nippoo/lawrencebutton/Electronics/lawrencebutton.kicad_pcb

## KiCad design Electronics/lawrencebutton.kicad_pcb (2021-02-03)

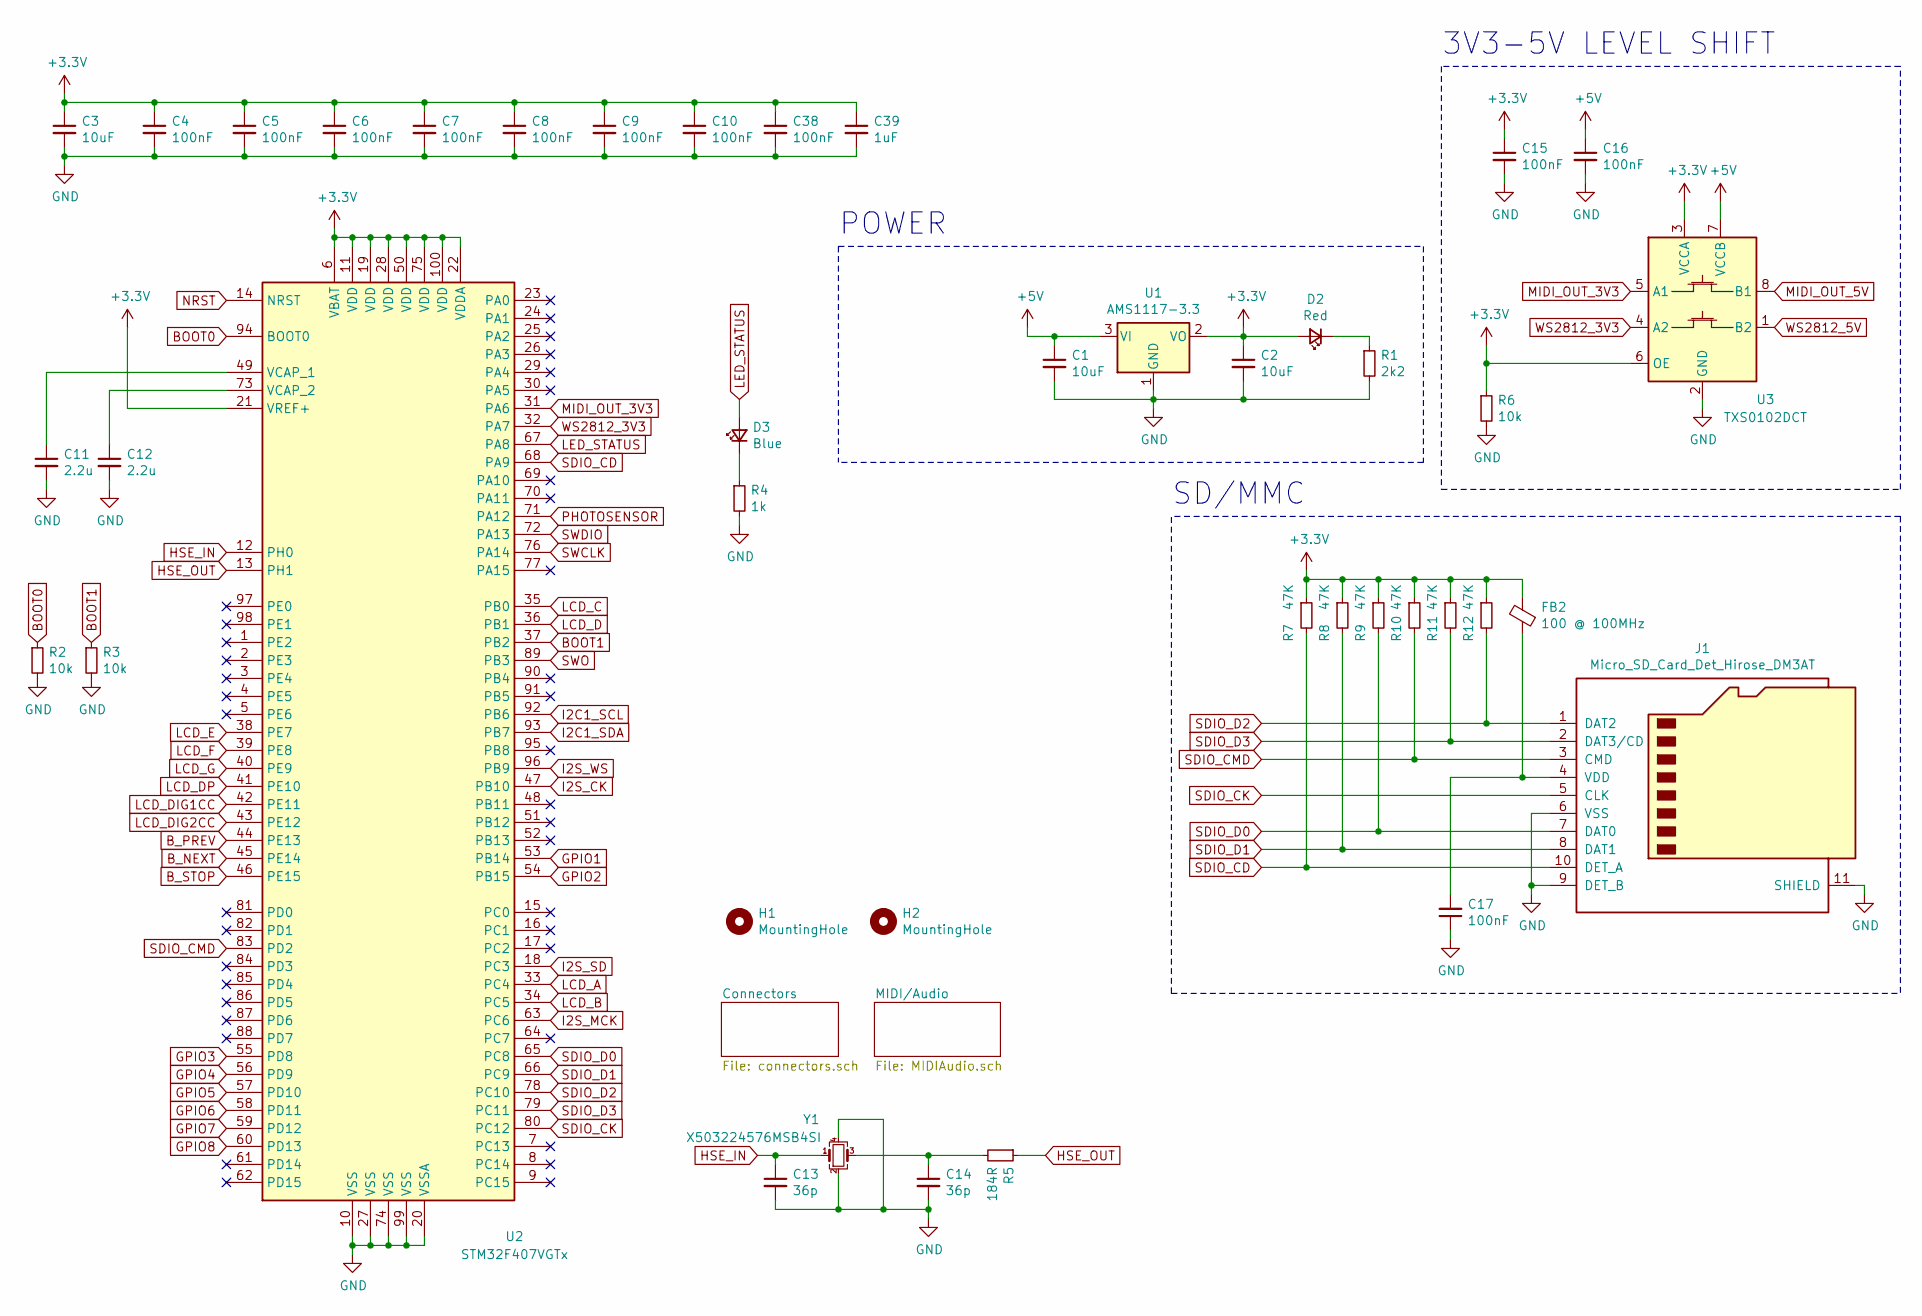
[picture p9: schematic lawrencebutton.sch, Lawrence Button Main Board]

Parts:
C1: 10uF; C_0603_1608Metric; LCSC C19702
C2, C3: 10uF; C_0402_1005Metric; LCSC C15525
C4, C5, C6, C7, C8, C9, C10, C15, C16, C17, C38: 100nF; C_0402_1005Metric; LCSC C1525
C11, C12: 2.2u; C_0603_1608Metric; LCSC C23630
C13, C14: 36p; C_0603_1608Metric; LCSC C1663
C39: 1uF; C_0402_1005Metric; LCSC C52923
D2: Red; LED_0805_2012Metric; LCSC C84256
D3: Blue; LED_0805_2012Metric; LCSC C2293
FB2: 100 @ 100MHz; L_0805_2012Metric; LCSC C1015
H1, H2: MountingHole; MountingHole_3.2mm_M3_Pad_Via
J1: Micro_SD_Card_Det_Hirose_DM3AT; microSD_HC_Hirose_DM3AT-SF-PEJM5
R1: 2k2; R_0603_1608Metric; LCSC C4190
R2, R3, R6: 10k; R_0603_1608Metric; LCSC C25804
R4: 1k; R_0603_1608Metric; LCSC C21190
R5: 184R; R_0603_1608Metric; LCSC C22828
R7, R8, R9, R10, R11, R12: 47K; R_0402_1005Metric; LCSC C25792
U1: AMS1117-3.3; SOT-223-3_TabPin2; LCSC C6186
U2: STM32F407VGTx; LQFP-100_14x14mm_P0.5mm; LCSC C12345
U3: TXS0102DCT; SSOP-8_2.95x2.8mm_P0.65mm; LCSC C324082
Y1: X503224576MSB4SI; Crystal_SMD_5032-4Pin_5.0x3.2mm; LCSC C112578

Connections:
+3V3: C2.1, C3.1, C4.1, C5.1, C6.1, C7.1, C8.1, C9.1, C10.1, C15.1, C38.1, C39.1, D2.2 (A), FB2.2, R6.1, R7.1, R8.1, R9.1, R10.1, R11.1, R12.1, U1.2 (VO), U2.6 (VBAT), U2.11 (VDD), U2.19 (VDD), U2.21 (VREF+), U2.22 (VDDA), U2.28 (VDD), U2.50 (VDD), U2.75 (VDD), U2.100 (VDD), U3.3 (VCCA), U3.6 (OE); also elsewhere on the board
+5V: C1.1, C16.1, U1.3 (VI), U3.7 (VCCB); also elsewhere on the board
BOOT0: R2.1, U2.94 (BOOT0)
BOOT1: R3.1, U2.37 (PB2)
B_NEXT: U2.45 (PE14); also elsewhere on the board
B_PREV: U2.44 (PE13); also elsewhere on the board
B_STOP: U2.46 (PE15); also elsewhere on the board
GND: C1.2, C2.2, C3.2, C4.2, C5.2, C6.2, C7.2, C8.2, C9.2, C10.2, C11.2, C12.2, C13.2, C14.2, C15.2, C16.2, C17.1, C38.2, C39.2, J1.6 (VSS), J1.9 (DET_B), J1.11 (SHIELD), R1.2, R2.2, R3.2, R4.2, R6.2, U1.1 (GND), U2.10 (VSS), U2.20 (VSSA), U2.27 (VSS), U2.74 (VSS), U2.99 (VSS), U3.2 (GND), Y1.2, Y1.4; also elsewhere on the board
GPIO1: U2.53 (PB14); also elsewhere on the board
GPIO2: U2.54 (PB15); also elsewhere on the board
GPIO3: U2.55 (PD8); also elsewhere on the board
GPIO4: U2.56 (PD9); also elsewhere on the board
GPIO5: U2.57 (PD10); also elsewhere on the board
GPIO6: U2.58 (PD11); also elsewhere on the board
GPIO7: U2.59 (PD12); also elsewhere on the board
GPIO8: U2.60 (PD13); also elsewhere on the board
HSE_IN: C13.1, U2.12 (PH0), Y1.1
HSE_OUT: R5.1, U2.13 (PH1)
I2C1_SCL: U2.92 (PB6); also elsewhere on the board
I2C1_SDA: U2.93 (PB7); also elsewhere on the board
I2S_CK: U2.47 (PB10); also elsewhere on the board
I2S_MCK: U2.63 (PC6); also elsewhere on the board
I2S_SD: U2.18 (PC3); also elsewhere on the board
I2S_WS: U2.96 (PB9); also elsewhere on the board
LCD_A: U2.33 (PC4); also elsewhere on the board
LCD_B: U2.34 (PC5); also elsewhere on the board
LCD_C: U2.35 (PB0); also elsewhere on the board
LCD_D: U2.36 (PB1); also elsewhere on the board
LCD_DIG1CC: U2.42 (PE11); also elsewhere on the board
LCD_DIG2CC: U2.43 (PE12); also elsewhere on the board
LCD_DP: U2.41 (PE10); also elsewhere on the board
LCD_E: U2.38 (PE7); also elsewhere on the board
LCD_F: U2.39 (PE8); also elsewhere on the board
LCD_G: U2.40 (PE9); also elsewhere on the board
LED_STATUS: D3.2 (A), U2.67 (PA8)
MIDI_OUT_3V3: U2.31 (PA6), U3.5 (A1)
MIDI_OUT_5V: U3.8 (B1); also elsewhere on the board
NRST: U2.14 (NRST); also elsewhere on the board
unnamed: C11.1, U2.49 (VCAP_1)
unnamed: C12.1, U2.73 (VCAP_2)
unnamed: C14.1, R5.2, Y1.3
unnamed: C17.2, FB2.1, J1.4 (VDD)
unnamed: D2.1 (K), R1.1
unnamed: D3.1 (K), R4.1
PHOTOSENSOR: U2.71 (PA12); also elsewhere on the board
SDIO_CD: J1.10 (DET_A), R7.2, U2.68 (PA9)
SDIO_CK: J1.5 (CLK), U2.80 (PC12)
SDIO_CMD: J1.3 (CMD), R10.2, U2.83 (PD2)
SDIO_D0: J1.7 (DAT0), R9.2, U2.65 (PC8)
SDIO_D1: J1.8 (DAT1), R8.2, U2.66 (PC9)
SDIO_D2: J1.1 (DAT2), R12.2, U2.78 (PC10)
SDIO_D3: J1.2 (DAT3/CD), R11.2, U2.79 (PC11)
SWCLK: U2.76 (PA14); also elsewhere on the board
SWDIO: U2.72 (PA13); also elsewhere on the board
SWO: U2.89 (PB3); also elsewhere on the board
WS2812_3V3: U2.32 (PA7), U3.4 (A2)
WS2812_5V: U3.1 (B2); also elsewhere on the board

Notes on the sheet:
SD/MMC
POWER
3V3-5V LEVEL SHIFT

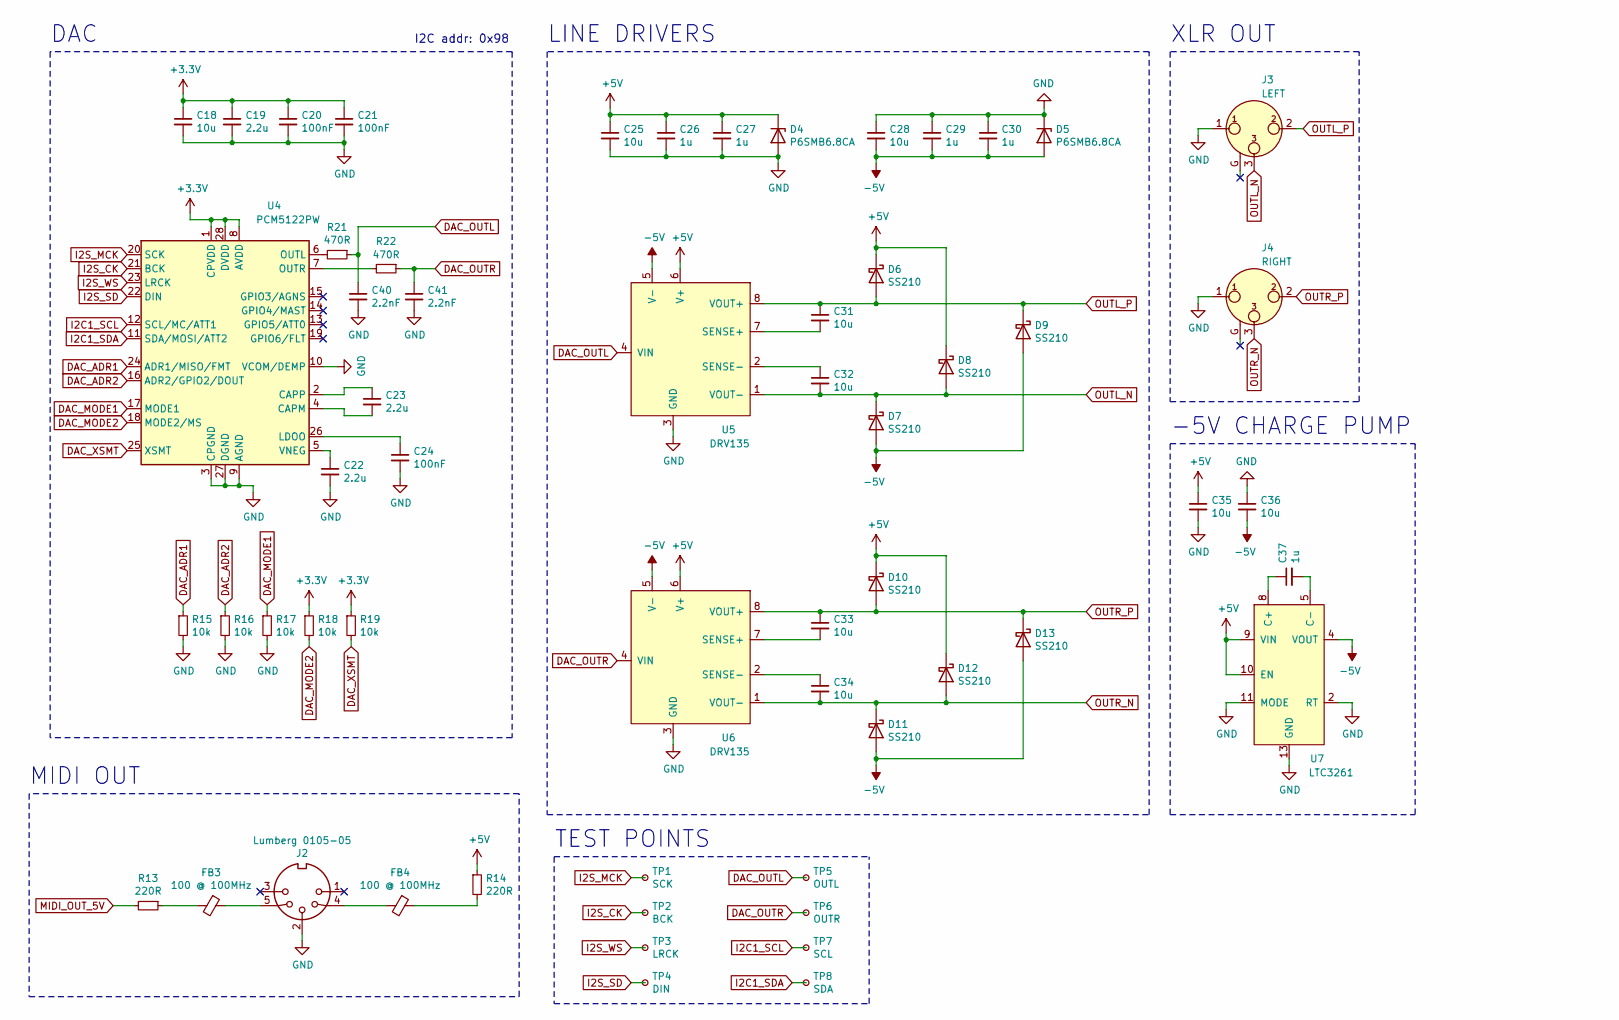
[picture p10: schematic MIDIAudio.sch, Lawrence Button Main Board, part in row 1, column 1]

Parts:
C18: 10u; C_0402_1005Metric; LCSC C15525
C19, C22, C23: 2.2u; C_0603_1608Metric; LCSC C23630
C20, C21, C24: 100nF; C_0402_1005Metric; LCSC C1525
C25, C28, C31, C32, C33, C34, C35, C36: 10u; C_0603_1608Metric; LCSC C19702
C26, C27, C29, C30, C37: 1u; C_0402_1005Metric; LCSC C52923
C40, C41: 2.2nF; C_0402_1005Metric; LCSC C1531
D4, D5: P6SMB6.8CA; D_SMB; LCSC C78395
D6, D7, D8, D9, D10, D11, D12, D13: SS210; D_SMA; LCSC C14996
FB3, FB4: 100 @ 100MHz; L_0805_2012Metric; LCSC C1015
J2: Lumberg 0105-05; Lumberg-0105-05
J3: LEFT; Jack_XLR_Neutrik_NC3MAH_Horizontal
J4: RIGHT; Jack_XLR_Neutrik_NC3MAH_Horizontal
R13, R14: 220R; R_0603_1608Metric; LCSC C22962
R15, R16, R17, R18, R19: 10k; R_0603_1608Metric; LCSC C25804
R21, R22: 470R; R_0402_1005Metric; LCSC C25117
TP1: SCK; TestPoint_Loop_D2.50mm_Drill1.0mm
TP2: BCK; TestPoint_Loop_D2.50mm_Drill1.0mm
TP3: LRCK; TestPoint_Loop_D2.50mm_Drill1.0mm
TP4: DIN; TestPoint_Loop_D2.50mm_Drill1.0mm
TP5: OUTL; TestPoint_Loop_D2.50mm_Drill1.0mm
TP6: OUTR; TestPoint_Loop_D2.50mm_Drill1.0mm
TP7: SCL; TestPoint_Loop_D2.50mm_Drill1.0mm
TP8: SDA; TestPoint_Loop_D2.50mm_Drill1.0mm
U4: PCM5122PW; TSSOP-28_4.4x9.7mm_P0.65mm
U5, U6: DRV135; SOIC-8_3.9x4.9mm_P1.27mm
U7: LTC3261; MSOP-12-1EP_3x4mm_P0.65mm_EP1.65x2.85mm_ThermalVias

Connections:
+3V3: C18.1, C19.1, C20.1, C21.1, R18.1, R19.1, U4.1 (CPVDD), U4.8 (AVDD), U4.28 (DVDD); also elsewhere on the board
+5V: C25.1, C26.1, C27.1, C35.1, D4.1 (K), D6.1 (K), D8.1 (K), D10.1 (K), D12.1 (K), R14.1, U5.6 (V+), U6.6 (V+), U7.9 (VIN), U7.10 (EN); also elsewhere on the board
-5V: C28.2, C29.2, C30.2, C36.2, D5.2 (A), D7.2 (A), D9.2 (A), D11.2 (A), D13.2 (A), U5.5 (V-), U6.5 (V-), U7.4 (VOUT)
DAC_ADR1: R15.1, U4.24 (ADR1/MISO/FMT)
DAC_ADR2: R16.1, U4.16 (ADR2/GPIO2/DOUT)
DAC_MODE1: R17.1, U4.17 (MODE1)
DAC_MODE2: R18.2, U4.18 (MODE2/MS)
DAC_OUTL: C40.1, R21.1, TP5.1, U5.4 (VIN)
DAC_OUTR: C41.1, R22.1, TP6.1, U6.4 (VIN)
DAC_XSMT: R19.2, U4.25 (XSMT)
GND: C18.2, C19.2, C20.2, C21.2, C22.2, C24.2, C25.2, C26.2, C27.2, C28.1, C29.1, C30.1, C35.2, C36.1, C40.2, C41.2, D4.2 (A), D5.1 (K), J2.2, J3.1, J4.1, R15.2, R16.2, R17.2, U4.3 (CPGND), U4.9 (AGND), U4.10 (VCOM/DEMP), U4.27 (DGND), U5.3 (GND), U6.3 (GND), U7.2 (RT), U7.11 (MODE), U7.13 (GND); also elsewhere on the board
I2C1_SCL: TP7.1, U4.12 (SCL/MC/ATT1); also elsewhere on the board
I2C1_SDA: TP8.1, U4.11 (SDA/MOSI/ATT2); also elsewhere on the board
I2S_CK: TP2.1, U4.21 (BCK); also elsewhere on the board
I2S_MCK: TP1.1, U4.20 (SCK); also elsewhere on the board
I2S_SD: TP4.1, U4.22 (DIN); also elsewhere on the board
I2S_WS: TP3.1, U4.23 (LRCK); also elsewhere on the board
MIDI_OUT_5V: R13.2; also elsewhere on the board
unnamed: C22.1, U4.5 (VNEG)
unnamed: C23.1, U4.2 (CAPP)
unnamed: C23.2, U4.4 (CAPM)
unnamed: C24.1, U4.26 (LDOO)
unnamed: C31.2, U5.7 (SENSE+)
unnamed: C32.1, U5.2 (SENSE-)
unnamed: C33.2, U6.7 (SENSE+)
unnamed: C34.1, U6.2 (SENSE-)
unnamed: C37.1, U7.8 (C+)
unnamed: C37.2, U7.5 (C-)
unnamed: FB3.1, J2.5
unnamed: FB3.2, R13.1
unnamed: FB4.1, R14.2
unnamed: FB4.2, J2.4
unnamed: R21.2, U4.6 (OUTL)
unnamed: R22.2, U4.7 (OUTR)
OUTL_N: C32.2, D7.1 (K), D8.2 (A), J3.3, U5.1 (VOUT-)
OUTL_P: C31.1, D6.2 (A), D9.1 (K), J3.2, U5.8 (VOUT+)
OUTR_N: C34.2, D11.1 (K), D12.2 (A), J4.3, U6.1 (VOUT-)
OUTR_P: C33.1, D10.2 (A), D13.1 (K), J4.2, U6.8 (VOUT+)

Notes on the sheet:
XLR OUT
LINE DRIVERS
DAC
MIDI OUT
I2C addr: 0x98
-5V CHARGE PUMP
TEST POINTS

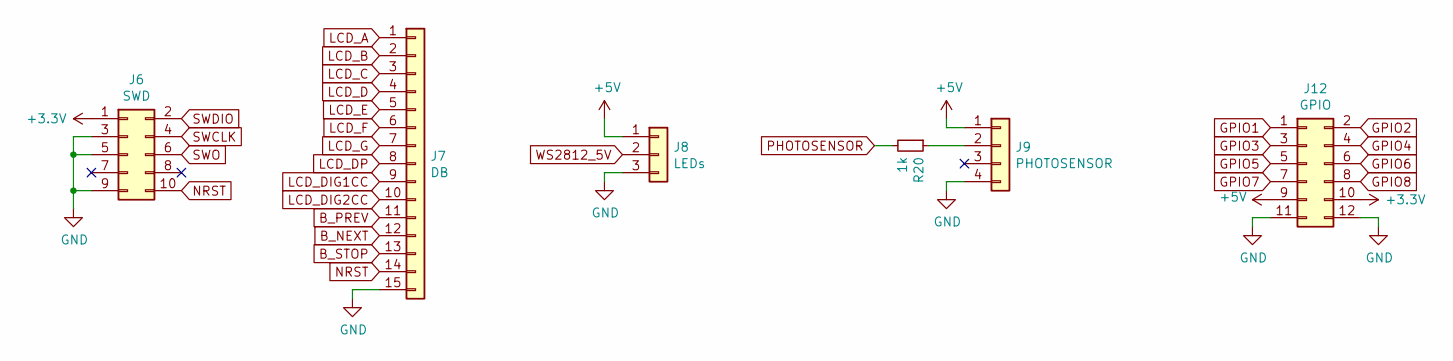
[picture p11: schematic connectors.sch, Lawrence Button Main Board]

Parts:
J6: SWD; PinHeader_2x05_P1.27mm_Vertical_SMD
J7: DB; Molex_PicoBlade_53048-1510_1x15_P1.25mm_Horizontal
J8: LEDs; Molex_PicoBlade_53048-0310_1x03_P1.25mm_Horizontal
J9: PHOTOSENSOR; Molex_PicoBlade_53048-0410_1x04_P1.25mm_Horizontal
J12: GPIO; PinHeader_2x06_P2.54mm_Vertical
R20: 1k; R_0603_1608Metric; LCSC C21190

Connections:
+3V3: J6.1, J12.10; also elsewhere on the board
+5V: J8.1, J9.1, J12.9; also elsewhere on the board
B_NEXT: J7.12; also elsewhere on the board
B_PREV: J7.11; also elsewhere on the board
B_STOP: J7.13; also elsewhere on the board
GND: J6.3, J6.5, J6.9, J7.15, J8.3, J9.4, J12.11, J12.12; also elsewhere on the board
GPIO1: J12.1; also elsewhere on the board
GPIO2: J12.2; also elsewhere on the board
GPIO3: J12.3; also elsewhere on the board
GPIO4: J12.4; also elsewhere on the board
GPIO5: J12.5; also elsewhere on the board
GPIO6: J12.6; also elsewhere on the board
GPIO7: J12.7; also elsewhere on the board
GPIO8: J12.8; also elsewhere on the board
LCD_A: J7.1; also elsewhere on the board
LCD_B: J7.2; also elsewhere on the board
LCD_C: J7.3; also elsewhere on the board
LCD_D: J7.4; also elsewhere on the board
LCD_DIG1CC: J7.9; also elsewhere on the board
LCD_DIG2CC: J7.10; also elsewhere on the board
LCD_DP: J7.8; also elsewhere on the board
LCD_E: J7.5; also elsewhere on the board
LCD_F: J7.6; also elsewhere on the board
LCD_G: J7.7; also elsewhere on the board
NRST: J6.10, J7.14; also elsewhere on the board
unnamed: J9.2, R20.1
PHOTOSENSOR: R20.2; also elsewhere on the board
SWCLK: J6.4; also elsewhere on the board
SWDIO: J6.2; also elsewhere on the board
SWO: J6.6; also elsewhere on the board
WS2812_5V: J8.2; also elsewhere on the board

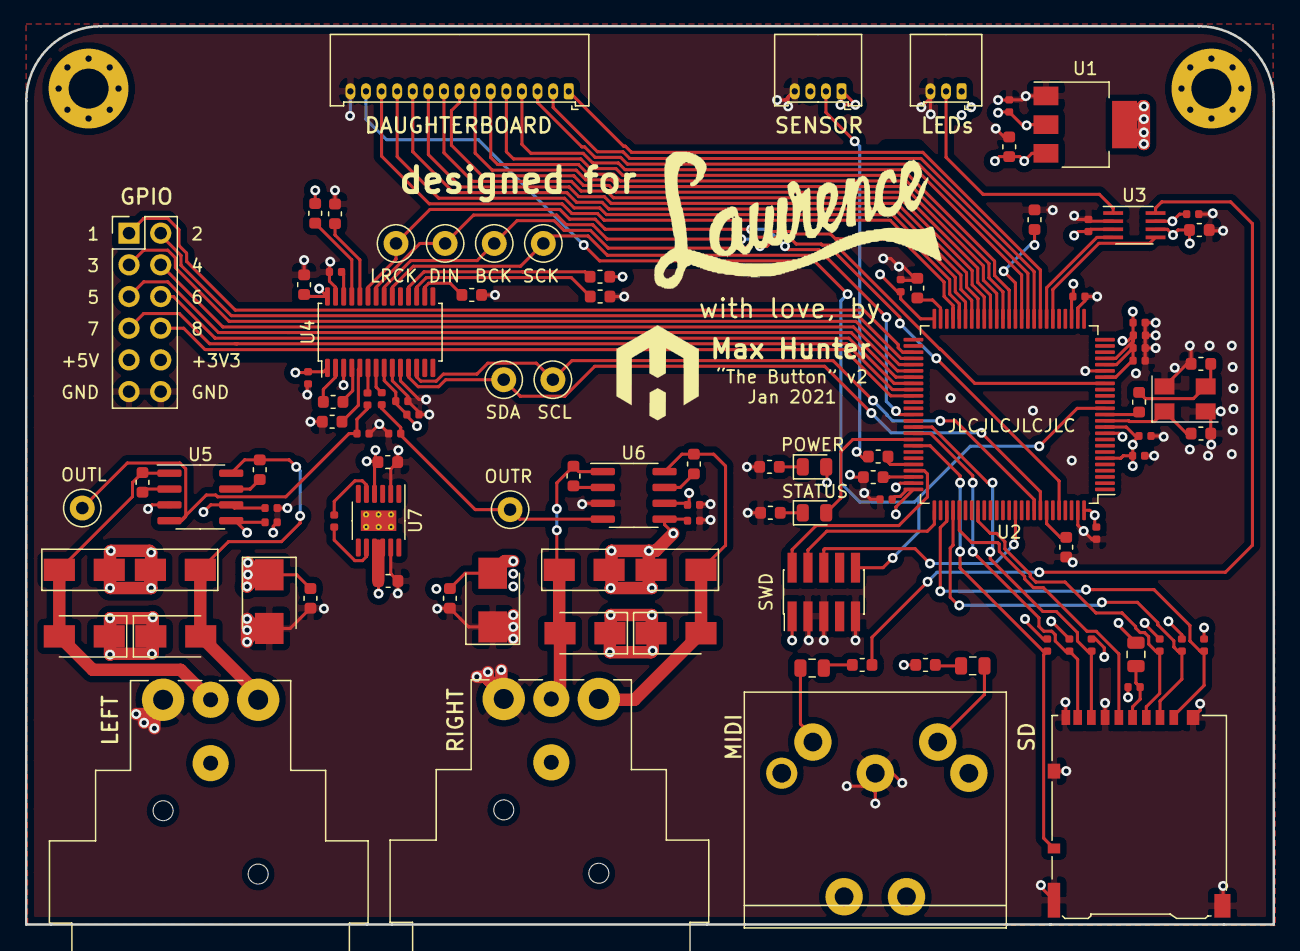
[picture p12: board lawrencebutton.kicad_pcb from above]

Board: 4 copper layers, 100.0 x 72.0 mm, 105 parts (0 on the bottom side), 86 nets.
