nippoo/lawrencebutton/Electronics/daughterboard.kicad_pcb

## KiCad design Electronics/daughterboard.kicad_pcb (2021-02-02)

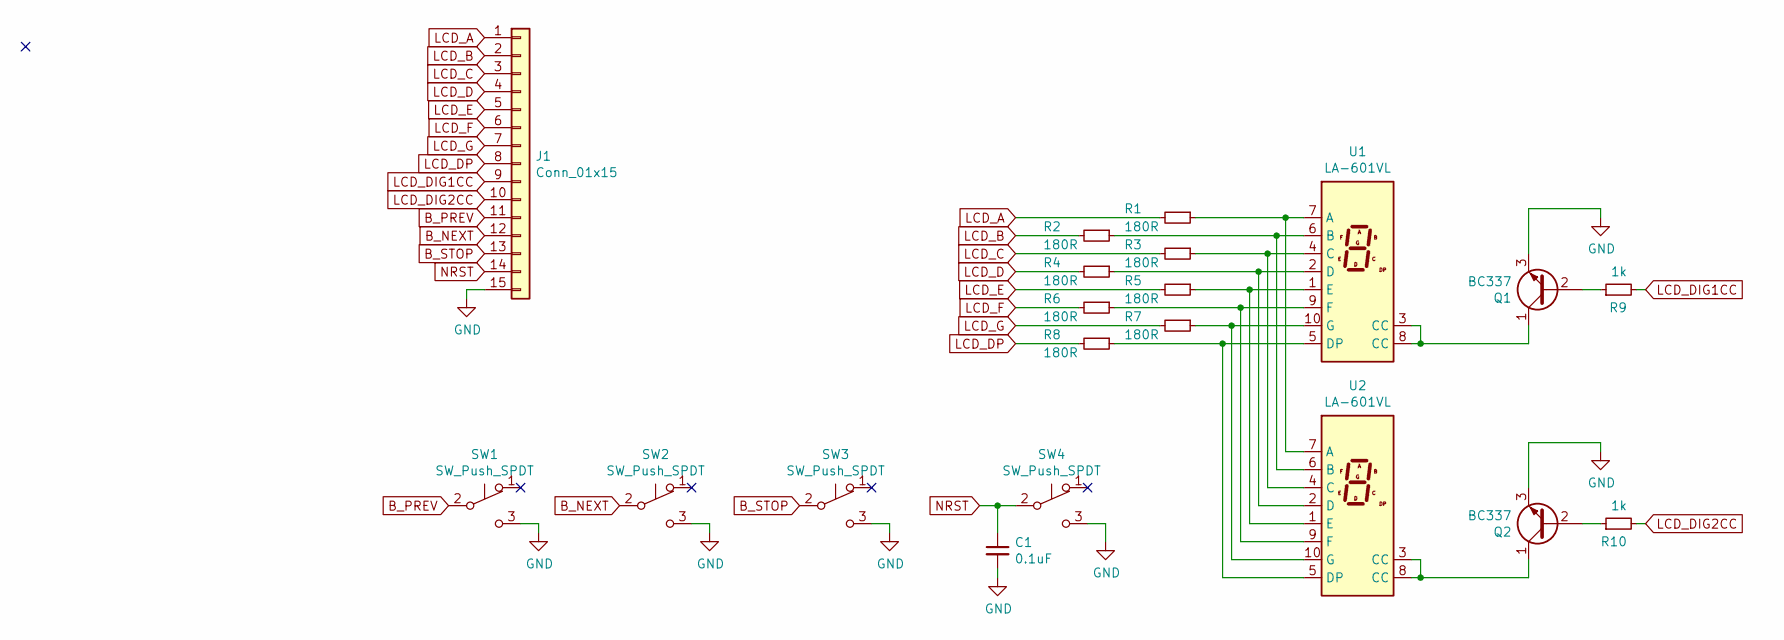
[picture p13: schematic daughterboard.sch]

Parts:
C1: 0.1uF; C_Disc_D3.8mm_W2.6mm_P2.50mm
J1: Conn_01x15; Molex_PicoBlade_53048-1510_1x15_P1.25mm_Horizontal
Q1, Q2: BC337; TO-92_Inline
R1, R2, R3, R4, R5, R6, R7, R8: 180R; R_Axial_DIN0207_L6.3mm_D2.5mm_P7.62mm_Horizontal
R9, R10: 1k; R_Axial_DIN0207_L6.3mm_D2.5mm_P7.62mm_Horizontal
SW1, SW2, SW3, SW4: SW_Push_SPDT; SPDT Push Switch RS 734-6788
U1, U2: LA-601VL; 7SegmentLED_LTS6760_LTS6780

Connections:
B_NEXT: J1.12, SW2.2 (B)
B_PREV: J1.11, SW1.2 (B)
B_STOP: J1.13, SW3.2 (B)
GND: C1.2, J1.15, Q1.3 (E), Q2.3 (E), SW1.3 (C), SW2.3 (C), SW3.3 (C), SW4.3 (C)
LCD_A: J1.1, R1.2
LCD_B: J1.2, R2.2
LCD_C: J1.3, R3.2
LCD_D: J1.4, R4.2
LCD_DIG1CC: J1.9, R9.2
LCD_DIG2CC: J1.10, R10.2
LCD_DP: J1.8, R8.2
LCD_E: J1.5, R5.2
LCD_F: J1.6, R6.2
LCD_G: J1.7, R7.2
NRST: C1.1, J1.14, SW4.2 (B)
unnamed: Q1.1 (C), U1.3 (CC), U1.8 (CC)
unnamed: Q1.2 (B), R9.1
unnamed: Q2.1 (C), U2.3 (CC), U2.8 (CC)
unnamed: Q2.2 (B), R10.1
unnamed: R1.1, U1.7 (A), U2.7 (A)
unnamed: R2.1, U1.6 (B), U2.6 (B)
unnamed: R3.1, U1.4 (C), U2.4 (C)
unnamed: R4.1, U1.2 (D), U2.2 (D)
unnamed: R5.1, U1.1 (E), U2.1 (E)
unnamed: R6.1, U1.9 (F), U2.9 (F)
unnamed: R7.1, U1.10 (G), U2.10 (G)
unnamed: R8.1, U1.5 (DP), U2.5 (DP)

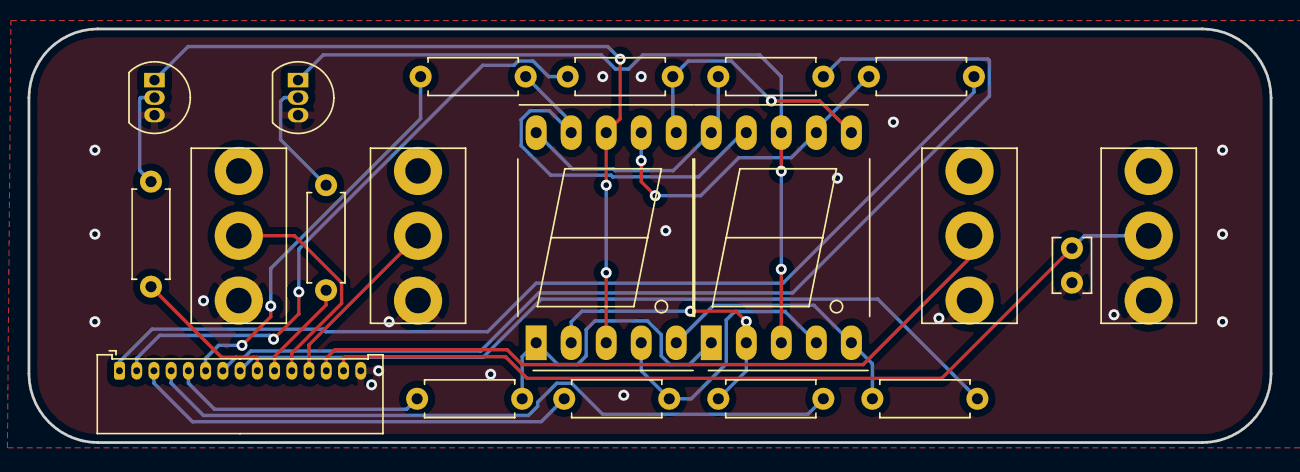
[picture p14: board daughterboard.kicad_pcb from above]

Board: 2 copper layers, 90.1 x 30.0 mm, 20 parts (0 on the bottom side), 27 nets.
