nippoo/lawrencebutton/(commit log)

2021-01-16 Initial main board schematic, pre layout
    [MIDIAudio.sch, connectors.sch, lawrencebutton.kicad_pcb, lawrencebutton.sch]
2021-01-17 First layout
    [MIDIAudio.sch, connectors.sch, lawrencebutton.kicad_pcb, lawrencebutton.sch]
2021-02-02 Initial software commit.
    [MIDIAudio.sch, connectors.sch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]
2021-02-03 working DMA circular audio buffer
2021-02-03 Initial working WS2812b code
    [lawrencebutton.kicad_pcb]
2021-02-09 v1 working, fixed red LED pulse
    [LawrenceButton.ioc, ffconf.h, main.c, main.h]
2021-04-08 Swapped RGB -> GRB for hex code LED
    [main.c]
